DilshanKularathna/EE4360-MicroMouse-Project-G4/Doc/Initial design diagram.jpeg

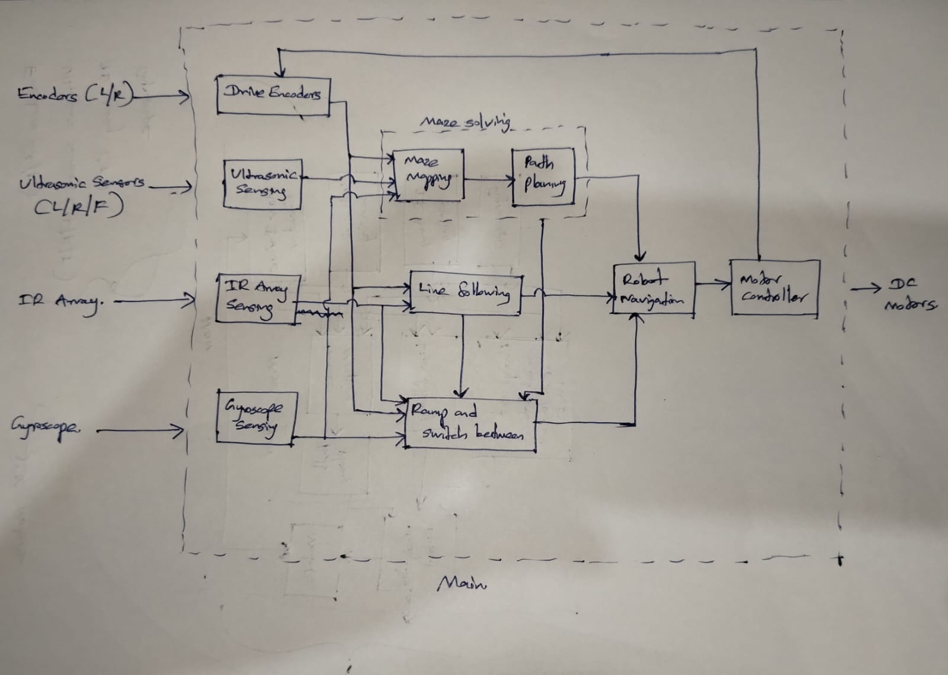
Doc/Initial design diagram.jpeg
