DilshanKularathna/EE4360-MicroMouse-Project-G4/Hardware Configuration/pinmap.md

# 📌 MicroMouse Hardware Pin Mapping Guide

This document outlines the standard hardware pin assignments for the **Arduino Mega 2560** used across all legacy Arduino test sketches and the modular PlatformIO codebase (`PlatformIO/include/config.h`).

All team members must follow this pin layout during physical assembly, testing, and debugging.
