DilshanKularathna/EE4360-MicroMouse-Project-G4/Mechanical Design/Assembly_bottom.SLDASM

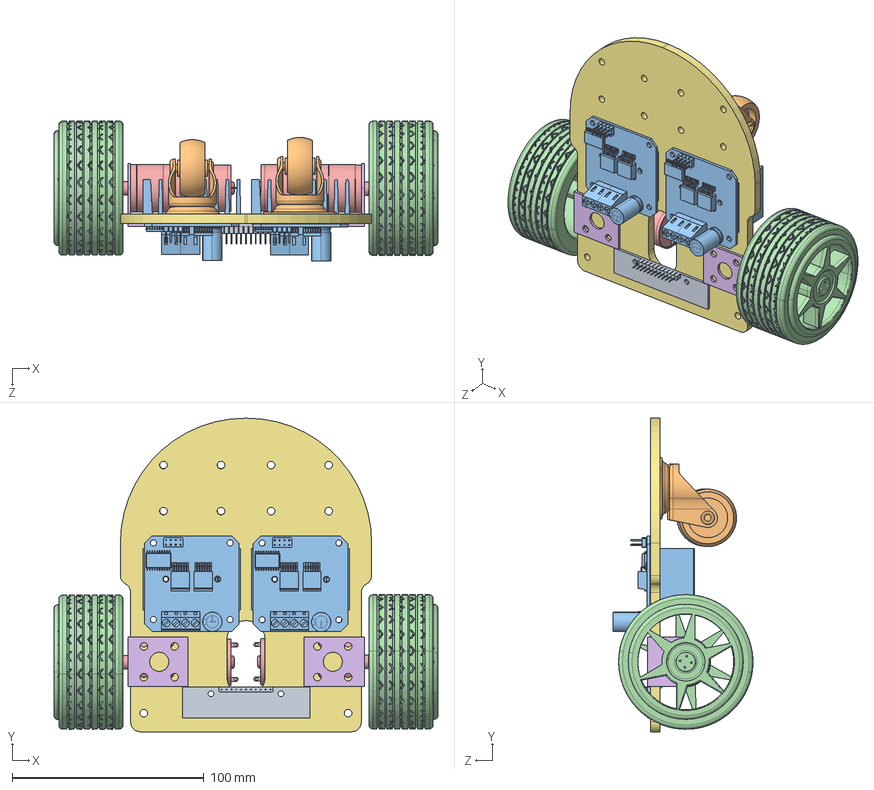
[picture p2: CAD file, 2026-09-30]
Mechanical Design/Assembly_bottom.SLDASM
200.2 x 163.5 x 73.0 mm
base_bottom
MTORO BRACKET x 2
JGA25-370 .step x 2
65mm robot wheel.step x 2
Motor Driver x 2
Caster-swivel-40mm_assembly.step x 2
IR ARRAY
