DilshanKularathna/EE4360-MicroMouse-Project-G4/Mechanical Design/Assembly_full.SLDASM

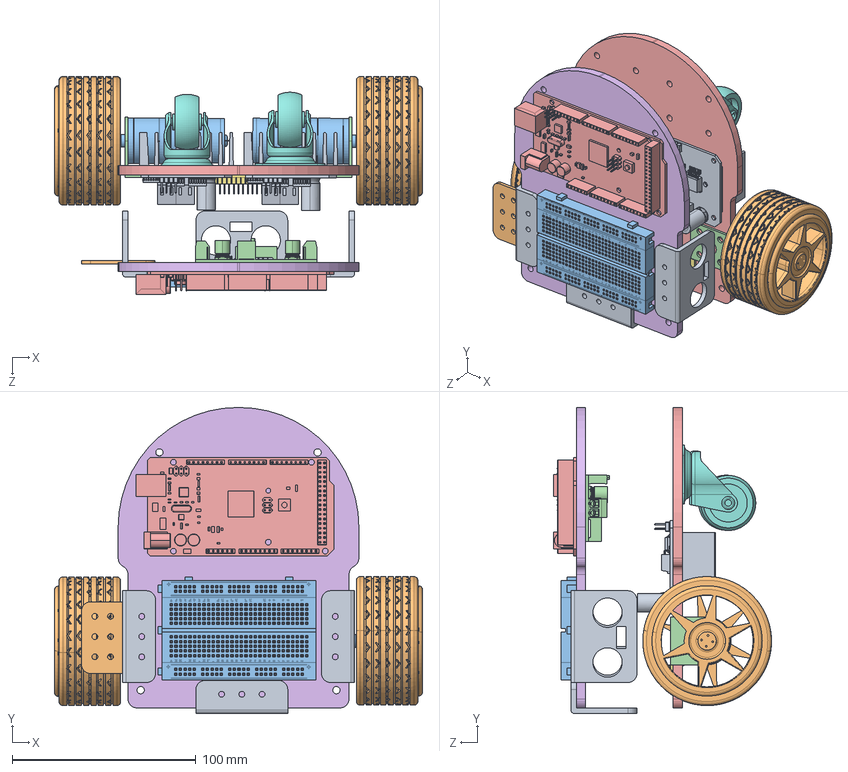
[picture p3: CAD file, 2026-09-30]
Mechanical Design/Assembly_full.SLDASM
200.2 x 166.5 x 118.7 mm
base_bottom
MTORO BRACKET x 2
JGA25-370 .step x 2
65mm robot wheel.step x 2
Motor Driver x 2
Caster-swivel-40mm_assembly.step x 2
IR ARRAY
base_top
ArduinoMega_STEP_AP203.step
LM2596 Buck Converter 4.0-40 to 1.3-37V.STEP
Base
pin header x 8
sensor chip
S2NH chip
Resistor small x 6
Resistor small black x 4
Small LED
Resistor black
Breadboard 400.stp
Ultrasonic_sensor_Shifters
Ulrasonic_mount x 3
