DilshanKularathna/EE4360-MicroMouse-Project-G4/Mechanical Design/Assembly_top.SLDASM

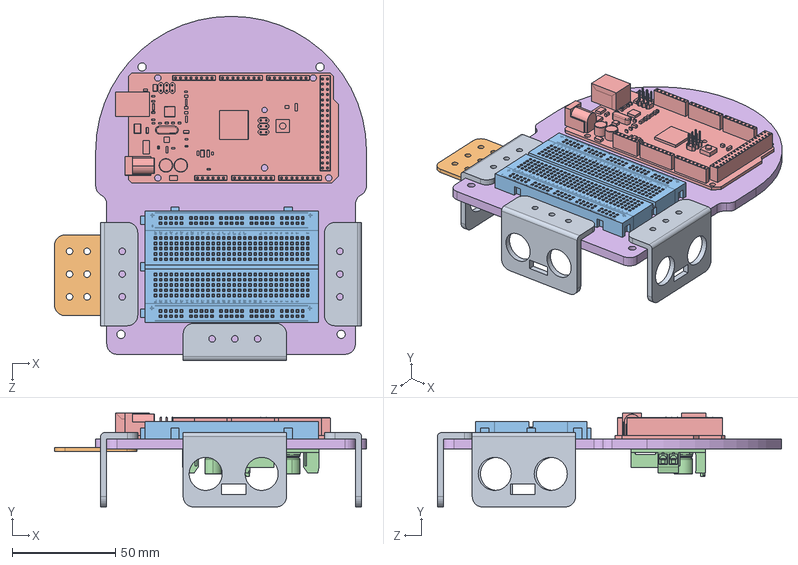
[picture p4: CAD file, 2026-09-30]
Mechanical Design/Assembly_top.SLDASM
150.9 x 45.4 x 166.5 mm
base_top
ArduinoMega_STEP_AP203.step
LM2596 Buck Converter 4.0-40 to 1.3-37V.STEP
Base
pin header x 8
sensor chip
S2NH chip
Resistor small x 6
Resistor small black x 4
Small LED
Resistor black
Breadboard 400.stp
Ultrasonic_sensor_Shifters
Ulrasonic_mount x 3
