DilshanKularathna/EE4360-MicroMouse-Project-G4/Mechanical Design/Parts/Caster-swivel-40mm_assembly.step.SLDPRT

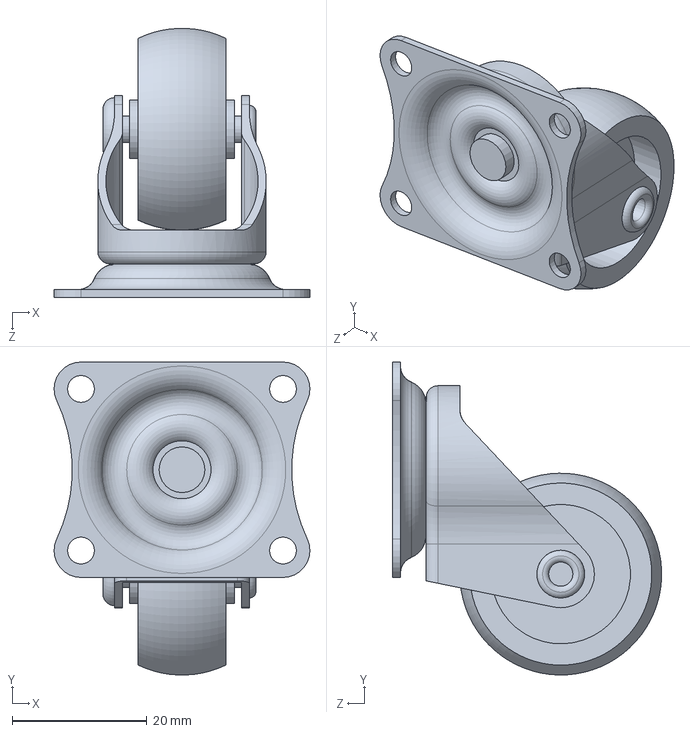
[picture p5: CAD file, 2026-09-17]
Mechanical Design/Parts/Caster-swivel-40mm_assembly.step.SLDPRT
38.0 x 46.5 x 40.0 mm
