DilshanKularathna/EE4360-MicroMouse-Project-G4/Mechanical Design/Laser cutting/base_bottom_v1.2.DXF

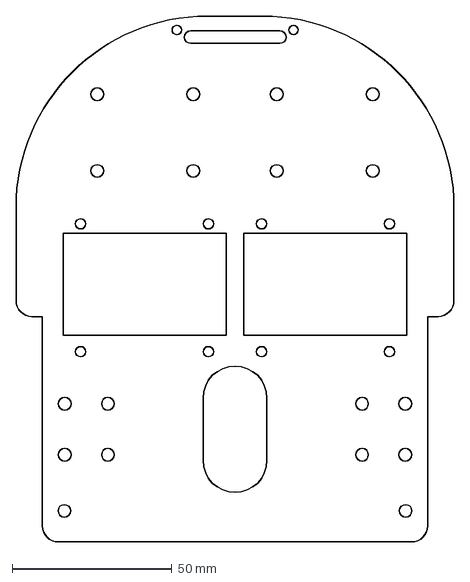
[picture p6: CAD file, 2026-09-18]
Mechanical Design/Laser cutting/base_bottom_v1.2.DXF
137.0 x 164.5 mm
