DilshanKularathna/EE4360-MicroMouse-Project-G4/Mechanical Design/Parts/sensor chip.SLDPRT

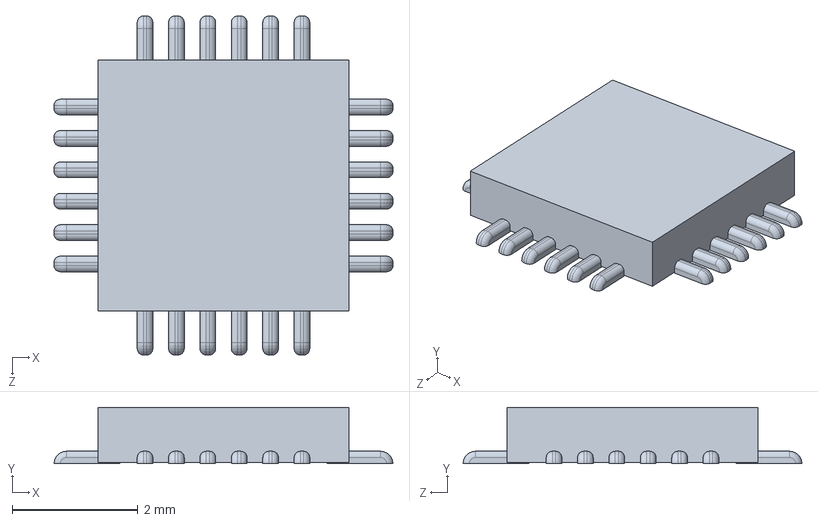
[picture p7: CAD file, 2026-09-30]
Mechanical Design/Parts/sensor chip.SLDPRT
5.40 x 0.9 x 5.40 mm
