DilshanKularathna/EE4360-MicroMouse-Project-G4/Mechanical Design/Parts/S2NH chip.SLDPRT

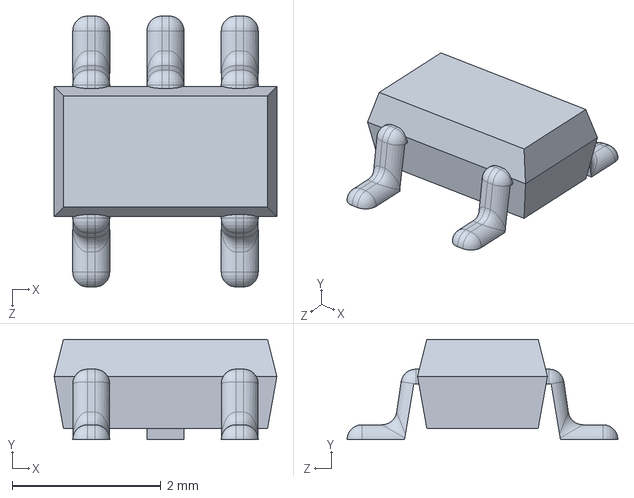
[picture p8: CAD file, 2026-09-30]
Mechanical Design/Parts/S2NH chip.SLDPRT
3.00 x 1.35 x 3.65 mm
