DilshanKularathna/EE4360-MicroMouse-Project-G4/Mechanical Design/Parts/Resistor black.SLDPRT

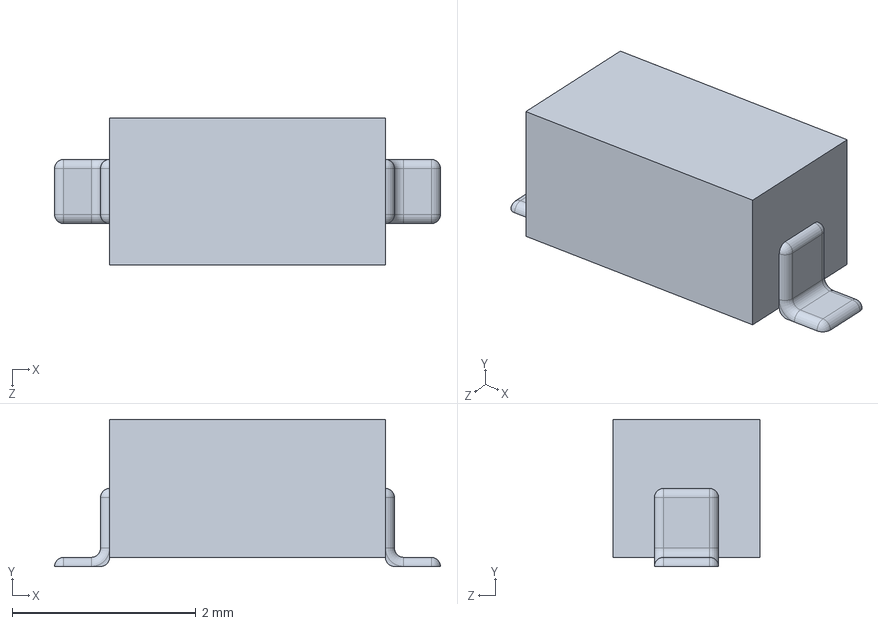
[picture p9: CAD file, 2026-09-30]
Mechanical Design/Parts/Resistor black.SLDPRT
4.20 x 1.60 x 1.60 mm
