DilshanKularathna/EE4360-MicroMouse-Project-G4/Mechanical Design/Parts/base_bottom.SLDPRT

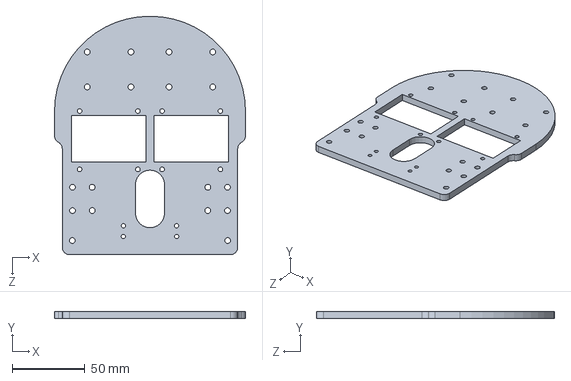
[picture p10: CAD file, 2026-09-30]
Mechanical Design/Parts/base_bottom.SLDPRT
131.0 x 5.00 x 163.5 mm
