DilshanKularathna/EE4360-MicroMouse-Project-G4/Mechanical Design/Parts/Small LED.SLDPRT

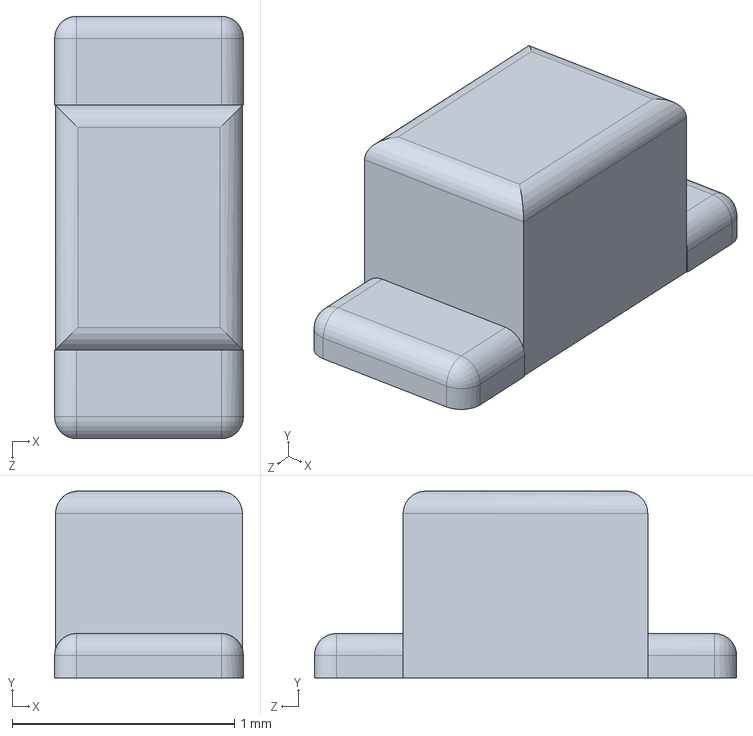
[picture p11: CAD file, 2026-09-30]
Mechanical Design/Parts/Small LED.SLDPRT
0.85 x 0.84 x 1.90 mm
