DilshanKularathna/EE4360-MicroMouse-Project-G4/Mechanical Design/Parts/Ulrasonic_mount.SLDPRT

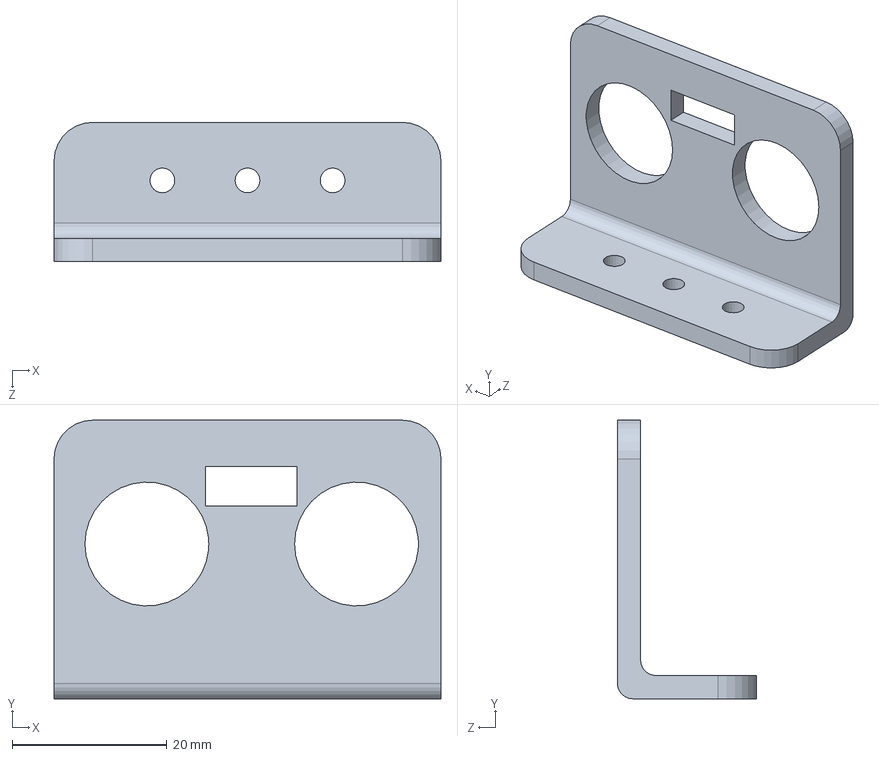
[picture p12: CAD file, 2026-09-30]
Mechanical Design/Parts/Ulrasonic_mount.SLDPRT
50.0 x 36.0 x 18.0 mm
