DilshanKularathna/EE4360-MicroMouse-Project-G4/Mechanical Design/Parts/ULTRASONICwith holder ALIGNED.SLDPRT

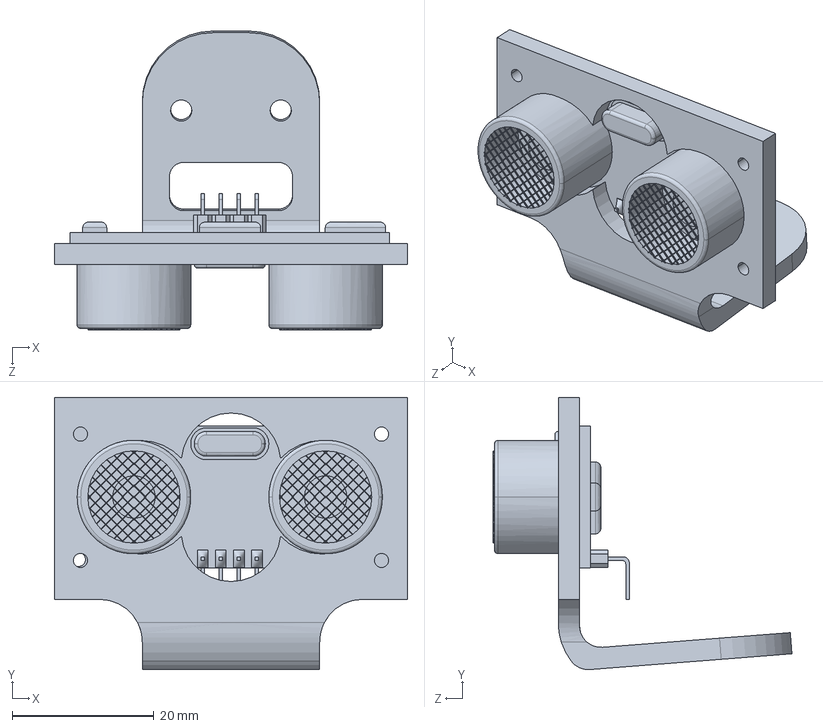
[picture p13: CAD file, 2026-09-30]
Mechanical Design/Parts/ULTRASONICwith holder ALIGNED.SLDPRT
49.7 x 38.3 x 42.1 mm
