DilshanKularathna/EE4360-MicroMouse-Project-G4/Mechanical Design/Parts/pin header.SLDPRT

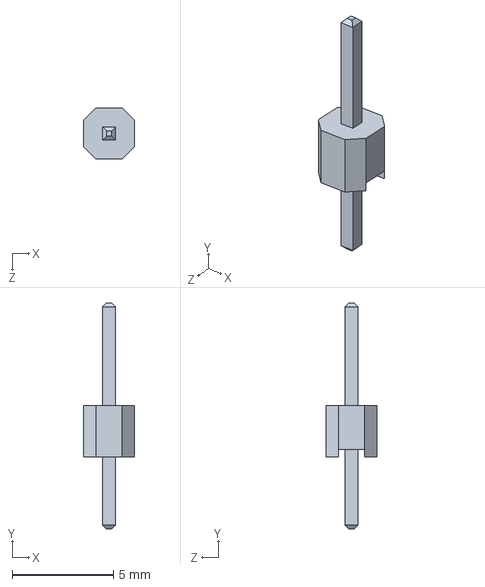
[picture p14: CAD file, 2026-09-30]
Mechanical Design/Parts/pin header.SLDPRT
2.54 x 11.2 x 2.54 mm
