DilshanKularathna/EE4360-MicroMouse-Project-G4/Mechanical Design/Parts/Breadboard 400.stp.SLDPRT

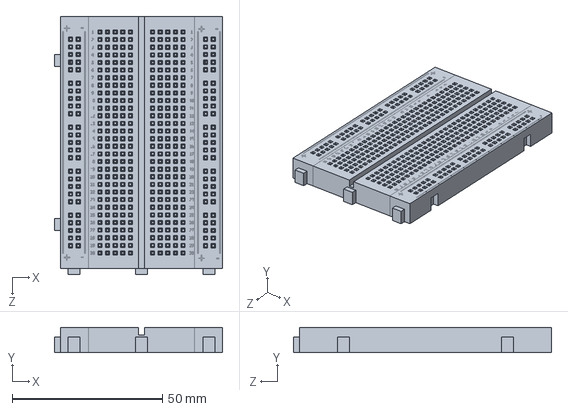
[picture p15: CAD file, 2026-09-30]
Mechanical Design/Parts/Breadboard 400.stp.SLDPRT
56.0 x 8.41 x 86.0 mm
