DilshanKularathna/EE4360-MicroMouse-Project-G4/Mechanical Design/Parts/Ultrasonic_sensor_Shifters.SLDPRT

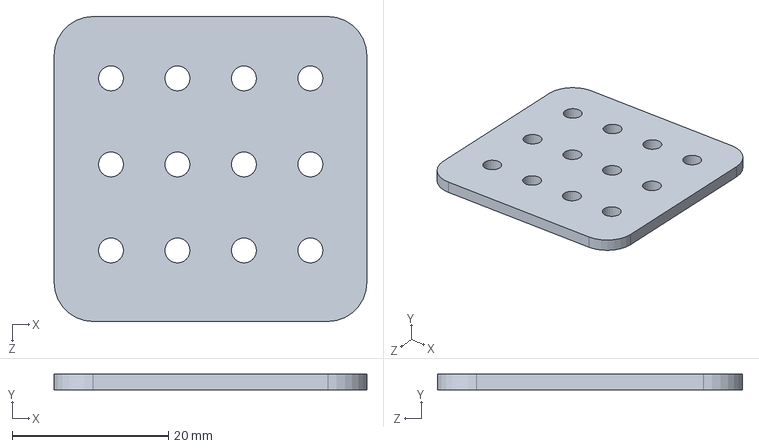
[picture p16: CAD file, 2026-09-30]
Mechanical Design/Parts/Ultrasonic_sensor_Shifters.SLDPRT
40.0 x 2.00 x 39.0 mm
