DilshanKularathna/EE4360-MicroMouse-Project-G4/Mechanical Design/Parts/MPU 6050 IMU.STEP

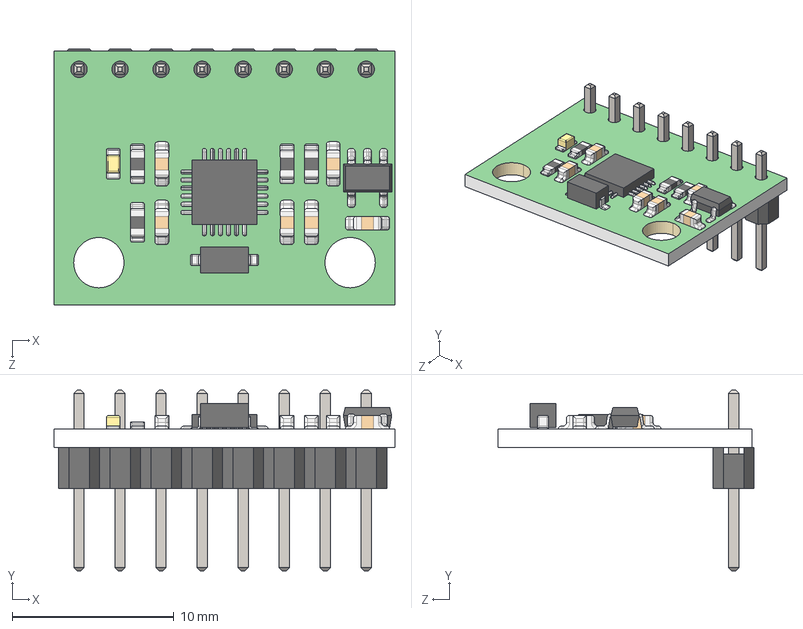
[picture p17: CAD file, 2026-09-30]
Mechanical Design/Parts/MPU 6050 IMU.STEP
21.1 x 11.2 x 15.9 mm
Base
pin header x 8
sensor chip
S2NH chip
Resistor small x 6
Resistor small black x 4
Small LED
Resistor black
