DilshanKularathna/EE4360-MicroMouse-Project-G4/Mechanical Design/Parts/Resistor small.SLDPRT

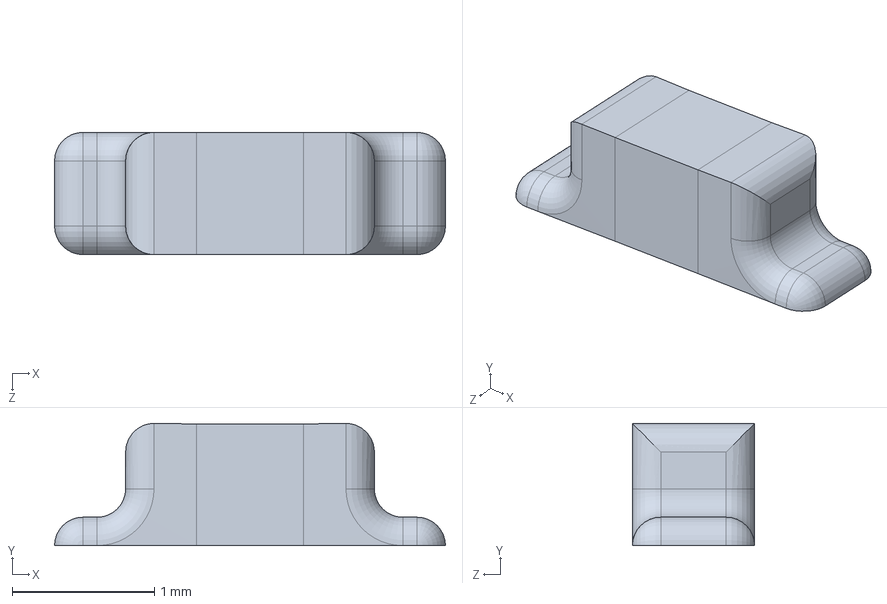
[picture p18: CAD file, 2026-09-30]
Mechanical Design/Parts/Resistor small.SLDPRT
2.75 x 0.86 x 0.86 mm
