DilshanKularathna/EE4360-MicroMouse-Project-G4/Mechanical Design/Parts/Base.SLDPRT

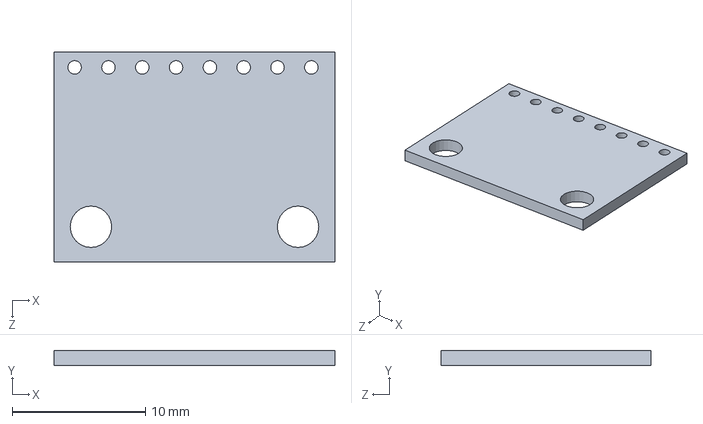
[picture p19: CAD file, 2026-09-30]
Mechanical Design/Parts/Base.SLDPRT
21.1 x 1.14 x 15.7 mm
