DilshanKularathna/EE4360-MicroMouse-Project-G4/Mechanical Design/Parts/base_top.SLDPRT

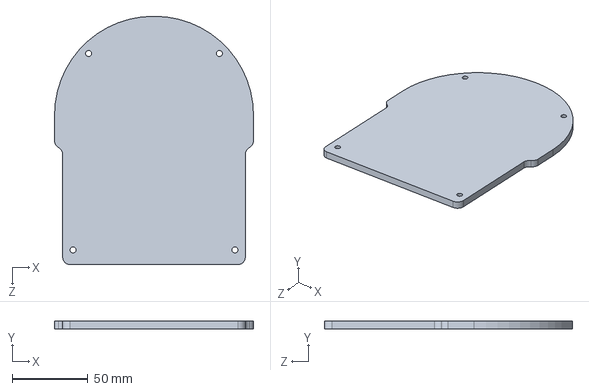
[picture p20: CAD file, 2026-09-30]
Mechanical Design/Parts/base_top.SLDPRT
131.0 x 5.00 x 163.5 mm
