DilshanKularathna/EE4360-MicroMouse-Project-G4/Mechanical Design/Parts/ArduinoMega_STEP_AP203.step.SLDPRT

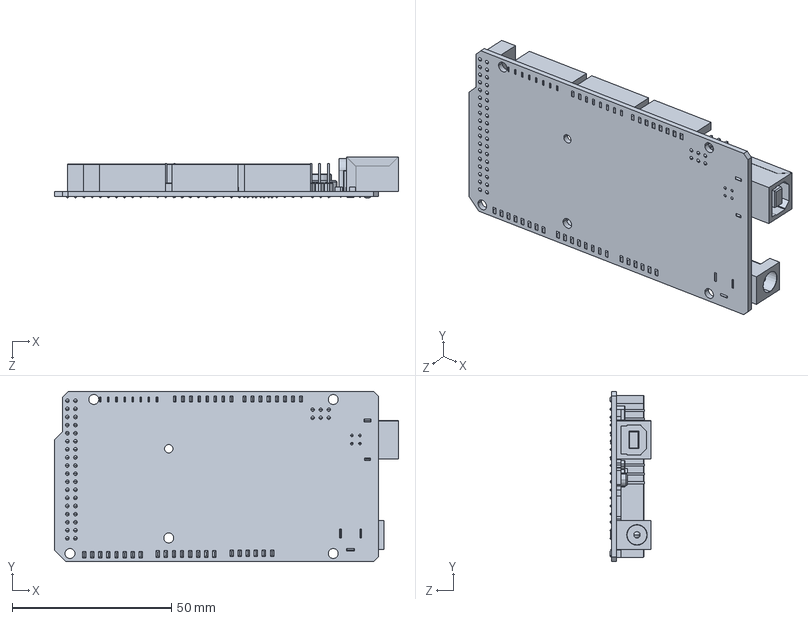
[picture p21: CAD file, 2026-09-30]
Mechanical Design/Parts/ArduinoMega_STEP_AP203.step.SLDPRT
107.9 x 53.4 x 13.0 mm
