DilshanKularathna/EE4360-MicroMouse-Project-G4/Mechanical Design/Parts/Resistor small black.SLDPRT

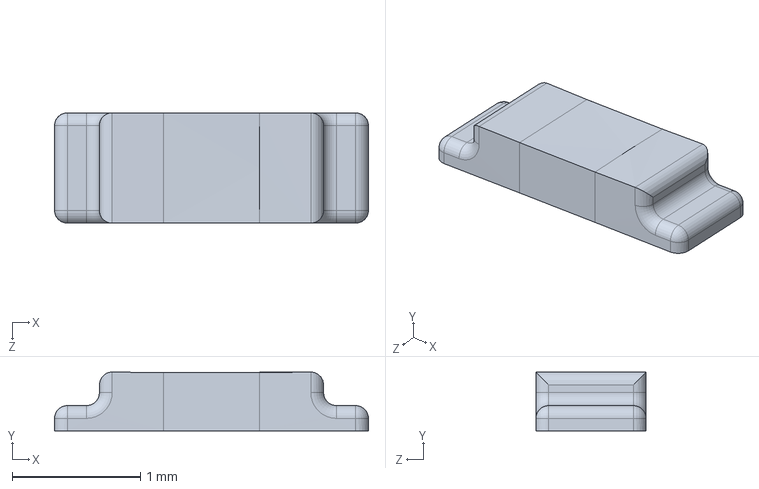
[picture p22: CAD file, 2026-09-30]
Mechanical Design/Parts/Resistor small black.SLDPRT
2.45 x 0.46 x 0.86 mm
