DilshanKularathna/EE4360-MicroMouse-Project-G4/Mechanical Design/Parts/LM2596 Buck Converter 4.0-40 to 1.3-37V.STEP.SLDPRT

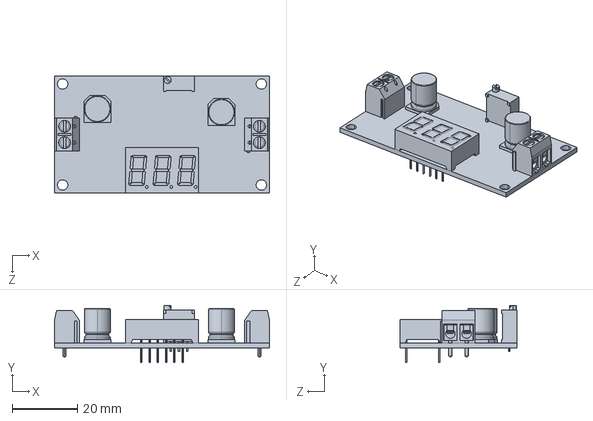
[picture p23: CAD file, 2026-09-30]
Mechanical Design/Parts/LM2596 Buck Converter 4.0-40 to 1.3-37V.STEP.SLDPRT
66.0 x 17.6 x 36.0 mm
