DilshanKularathna/EE4360-MicroMouse-Project-G4/Mechanical Design/Parts/JGA25-370 .step.SLDPRT

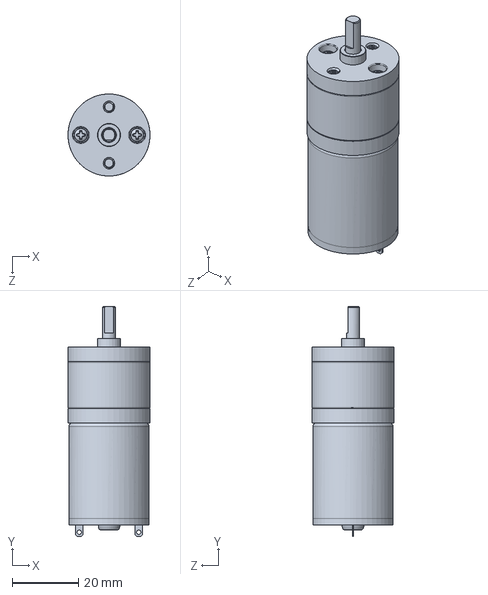
[picture p24: CAD file, 2026-09-17]
Mechanical Design/Parts/JGA25-370 .step.SLDPRT
24.8 x 69.5 x 24.8 mm
