DilshanKularathna/EE4360-MicroMouse-Project-G4/Mechanical Design/Parts/65mm robot wheel.step.SLDPRT

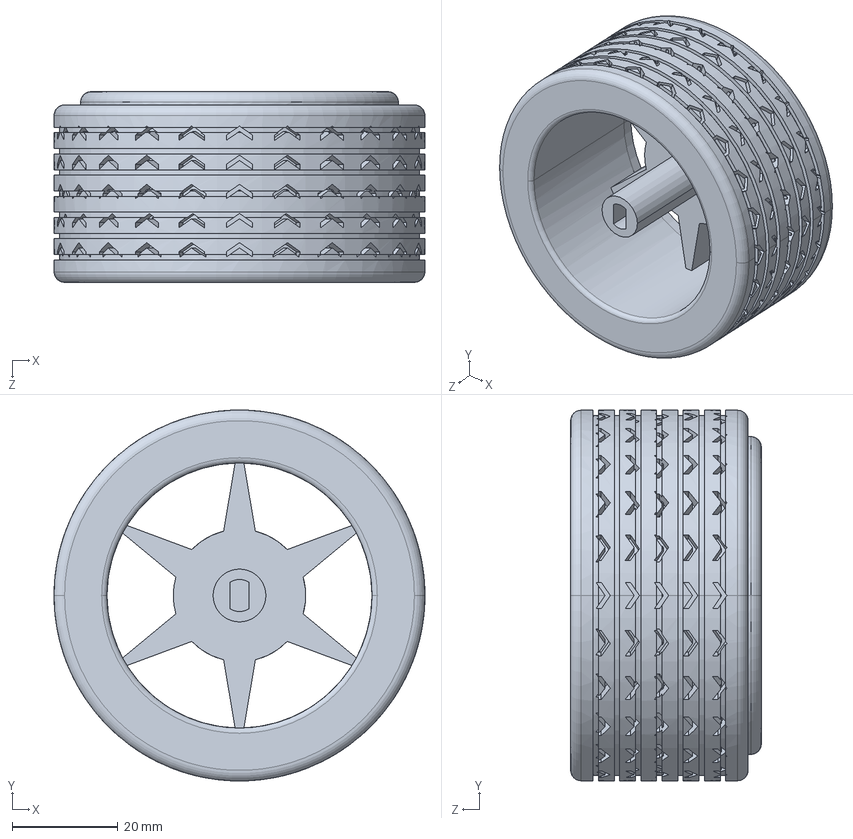
[picture p25: CAD file, 2026-09-17]
Mechanical Design/Parts/65mm robot wheel.step.SLDPRT
70.0 x 70.0 x 36.0 mm
