DilshanKularathna/EE4360-MicroMouse-Project-G4/Mechanical Design/Parts/MTORO BRACKET.SLDPRT

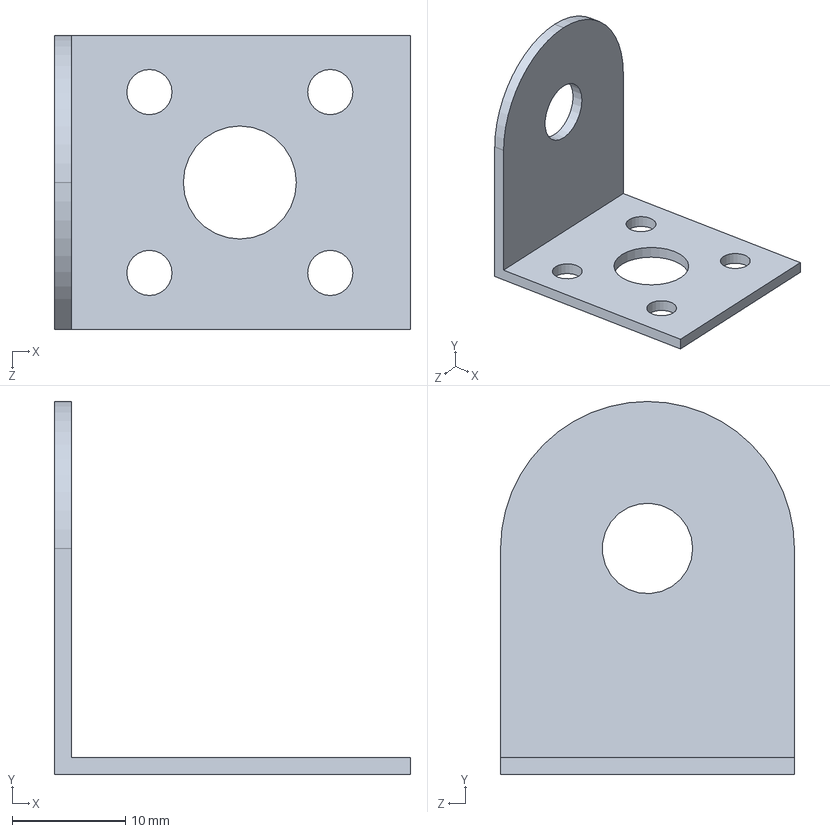
[picture p26: CAD file, 2026-09-17]
Mechanical Design/Parts/MTORO BRACKET.SLDPRT
31.5 x 33.0 x 26.0 mm
