DilshanKularathna/EE4360-MicroMouse-Project-G4/Mechanical Design/Parts/Motor Driver.SLDPRT

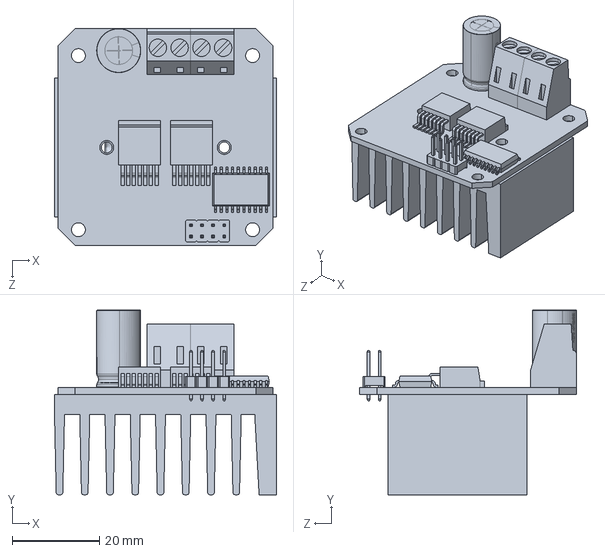
[picture p27: CAD file, 2026-09-17]
Mechanical Design/Parts/Motor Driver.SLDPRT
51.0 x 42.4 x 49.8 mm
