DilshanKularathna/EE4360-MicroMouse-Project-G4/Mechanical Design/Parts/Battery Pack.SLDPRT

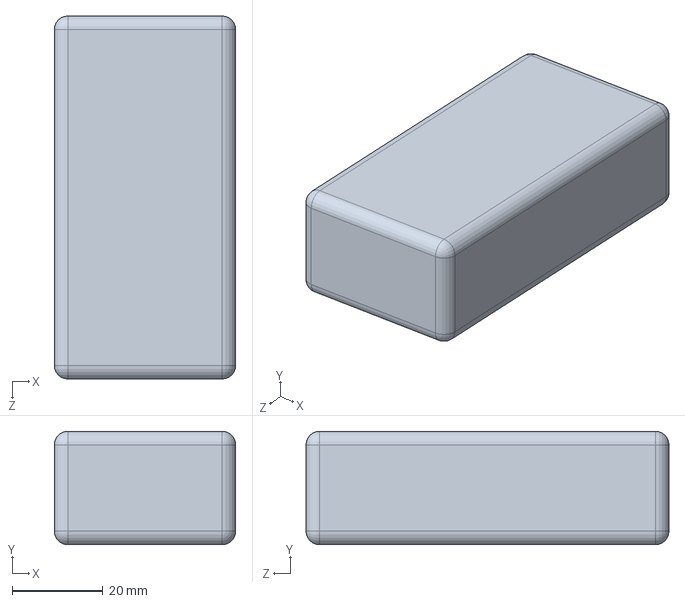
[picture p28: CAD file, 2026-09-17]
Mechanical Design/Parts/Battery Pack.SLDPRT
40.0 x 25.0 x 80.0 mm
