DilshanKularathna/EE4360-MicroMouse-Project-G4/Mechanical Design/Parts/IR ARRAY.SLDPRT

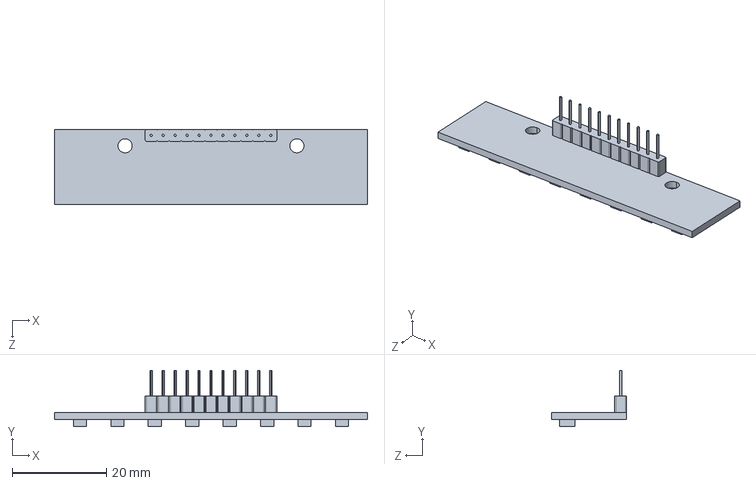
[picture p29: CAD file, 2026-09-17]
Mechanical Design/Parts/IR ARRAY.SLDPRT
66.5 x 12.0 x 16.0 mm
