DilshanKularathna/EE4360-MicroMouse-Project-G4/Mechanical Design/Parts/Ultrasonic_with_mount.SLDASM

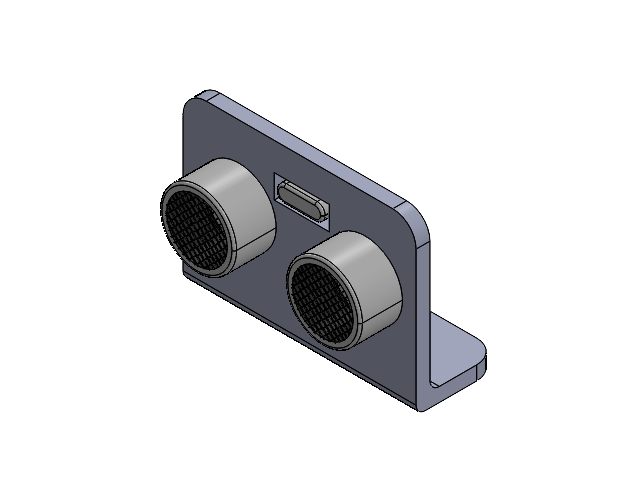
[picture p30: CAD file, 2026-09-30]
Mechanical Design/Parts/Ultrasonic_with_mount.SLDASM
Ulrasonic_mount
Ultrasonic HCSR04.step
