DilshanKularathna/EE4360-MicroMouse-Project-G4/(list of files, cad)

Other CAD files:
Mechanical Design/Laser cutting/base_bottom.DXF
Mechanical Design/Laser cutting/base_bottom_v1.0.DXF
Mechanical Design/Laser cutting/base_bottom_v1.1.DXF
Mechanical Design/Parts/MPU 6050 IMU.SLDASM
