DilshanKularathna/EE4360-MicroMouse-Project-G4/(commit log)

2026-09-17 Add MicroMouse project
    [65mm robot wheel.step.SLDPRT, ArduinoMega_STEP_AP203.step.SLDPRT, Assembly.SLDASM, Battery Pack.SLDPRT, Breadboard 400.stp.SLDPRT, Caster-swivel-40mm_assembly.step.SLDPRT, IR ARRAY.SLDPRT, JGA25-370 .step.SLDPRT]
2026-09-17 fix: Chassy compact design
    [Assembly.SLDASM, base_bottom.SLDPRT, base_bottom_update1.DXF]
2026-09-17 fix: minor adjustments
    [Assembly.SLDASM, base_bottom.SLDPRT]
2026-09-18 Add Arduino hardware configuration test sketches
    - irsensor_array: IR sensor array test sketch
    - motordrive_motors_test: Motor drive and motor test sketch
    - ultra_sonics: Ultrasonic sensor test sketch
2026-09-18 fix: Chassy Bottom Design, Motor Encoder Wiring Spacing
    [Assembly.SLDASM, base_bottom.SLDPRT, base_bottom_v1.0.DXF, base_bottom_v1.1.DXF, base_bottom_v1.2.DXF]
2026-09-24 change: Base bottom design add: Base top design
    [ArduinoMega_STEP_AP203.step.SLDPRT, Assembly.SLDASM, Assembly_bottom.SLDASM, Assembly_top.SLDASM, Base.SLDPRT, LM2596 Buck Converter 4.0-40 to 1.3-37V.STEP.SLDPRT, MPU 6050 IMU.SLDASM, MPU 6050 IMU.STEP]
2026-09-24 Alignment changes add: Ultrasonic Mounts new add: Mount holes
    [Assembly_full.SLDASM, Assembly_top.SLDASM, Breadboard 400.stp.SLDPRT, Ulrasonic_mount.SLDPRT, Ultrasonic_sensor_Shifters.SLDPRT, Ultrasonic_with_mount.SLDASM, base_top.SLDPRT]
2026-09-30 Add tested motor forward and 90 turn
2026-10-03 Added Hardware Configuration/Arduino Test/motor driver test to relevant PIO folders
2026-10-03 Removed motordrive_motors_test folder
2026-10-03 Added Hardware Configuration/Arduino Test/irsensor_array to relevant PIO folders
2026-10-03 Added HArdware Configuration/Arduino Test/ultra_sonics to relevant PIO folders
2026-10-03 refactor: Migrate Arduino sketches to modular PlatformIO architecture
2026-10-04 feat(hardware): IR sensor based line follower Arduino test
    - Add initial IR sensor line follower sketch under Hardware Configurations/Arduino Tests
    - NOTE: Left and right wheel motor pin notations should be interchanged
    - TODO: IR threshold value needs to be calculated/calibrated for reliable line detection
2026-10-13 Added Ultrasonic lib
